faoziaziz/pa_ui/docs/LNA_recv_GW.odt

LNA Notes

Aziz Faozi 19/10/2026

# Desain Drawing

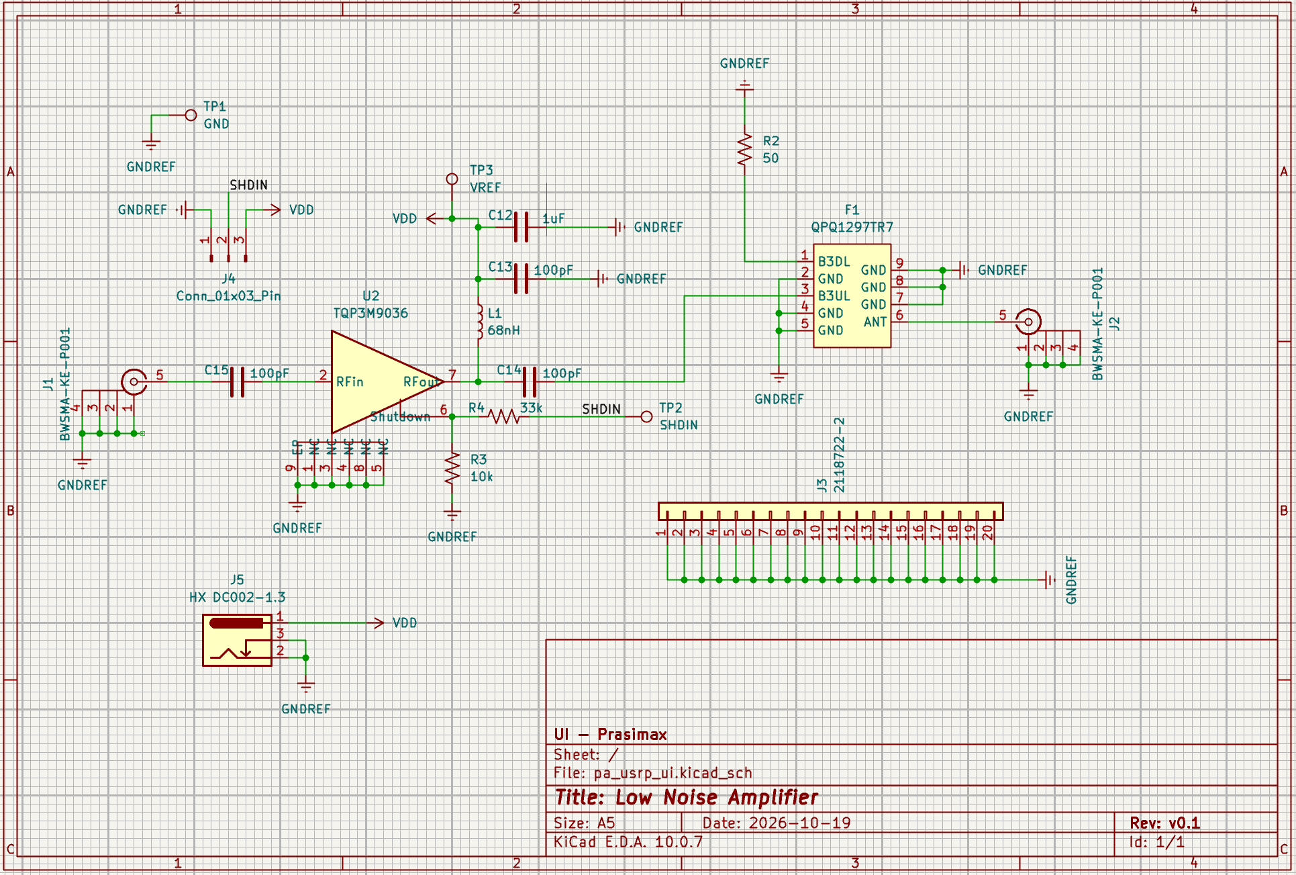
[picture p1: figure]

Figure 1: Rangkaian LNA

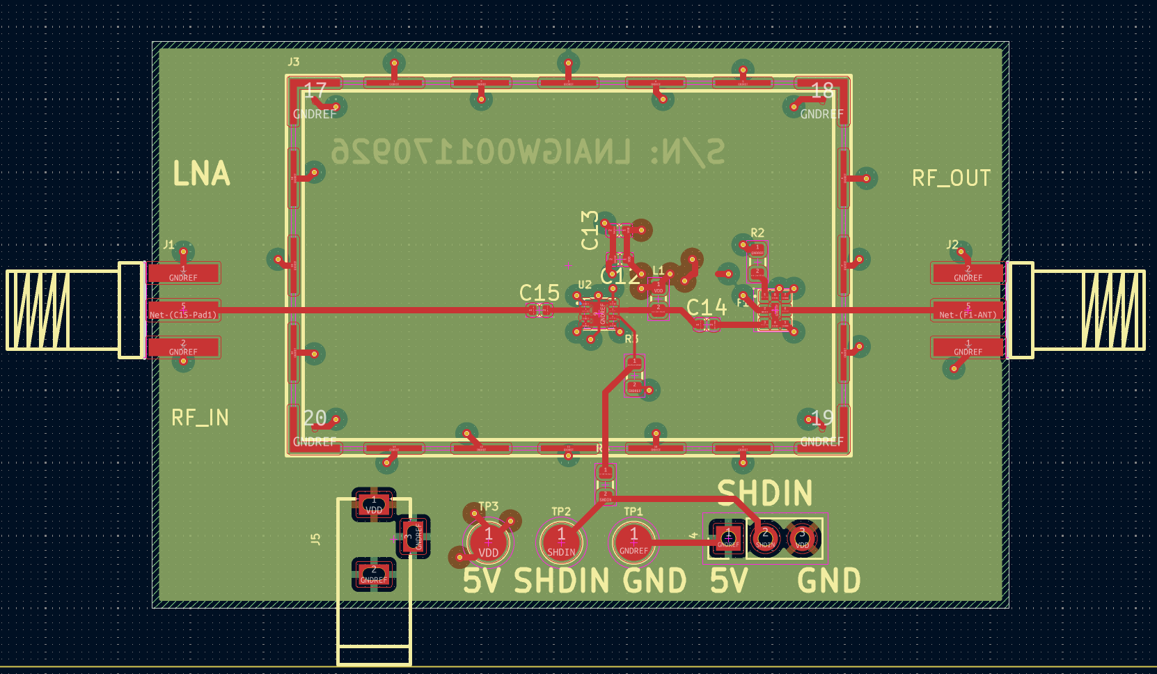
[picture p2: figure]

Figure 2: Rangkaian PCB.

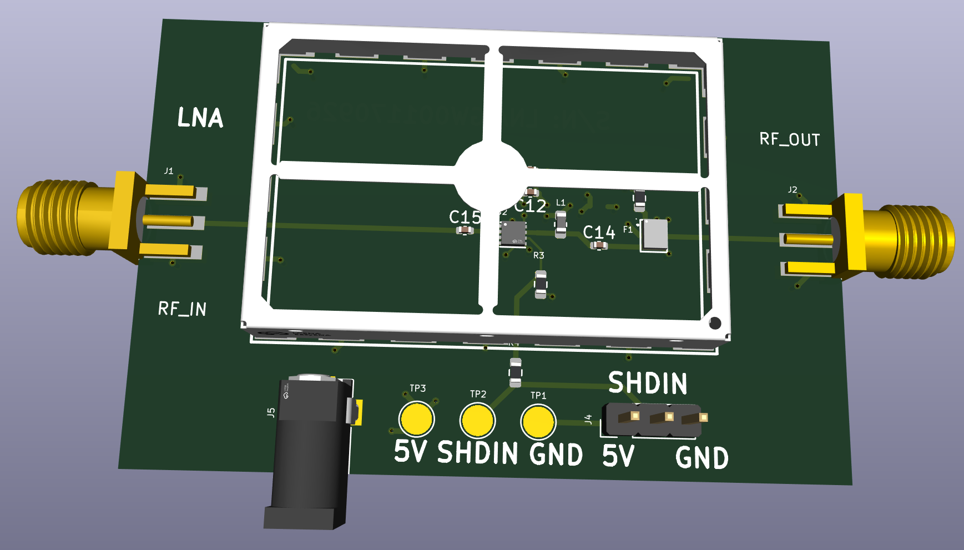
[picture p3: figure]

Figure 3: Gambar 3D dari LNA

Figure 1 adalah rangkaian Low Noise Amplifier, Figure 2 adalah bentuk PCB untuk Low Noise Amplifier. Perhatikan bahwa cara untuk mencatu amplifier tersbuet terbuka 3 pilihan yaitu dengan barrel jack seperti J5, pad untuk solder seperti test point dan pin header tulang ikan seperti pada konektor j4.

Reference | Qty | Value | price | lcsc_id | Total
C12 | 1 | 1uF | 0.01 | C52923 | 0.01
C13,C14,C15 | 3 | 100pF | 0 | C1546 | 0.01
F1 | 1 | QPQ1297TR7 | 8.01 | C471170 | 8.01
J1,J2 | 2 | BWSMA-KE-P001 | 0.41 | C496550 | 0.82
J3 | 1 | 2118722-2 | 2.01 | C5371638 | 2.01
J4 | 1 | Conn_01x03_Pin | | | 0
J5 | 1 | HX DC002-1.3 | 0.08 | C5184827 | 0.08
L1 | 1 | 68nH | 0.04 | C6364697 | 0.04
R2 | 1 | 50 | 0.03 | C849792 | 0.03
R3 | 1 | 10k | 0.01 | C25804 | 0.01
R4 | 1 | 33k | 0 | C4216 | 0
TP1 | 1 | GND | | | 0
TP2 | 1 | SHDIN | | | 0
TP3 | 1 | VREF | | | 0
U2 | 1 | TQP3M9036 | 3.13 | C920261 | 3.13
| | | | total | 14.14

# Performa Claim

Dari Figure satu kita melihat bahwa rangkaian input_rf akan melalui komponent berupa SMA connektor J1 → c15 → U2 → c13 → f1 → j2. Dengan mengetahui karakteristik dari jalur rf yang digunakan kita bisa menentukan perkiraan seperti gain maupun insertion loss dari rangkaian tersebut.

### J1,J2 : BWSMA-KE-P001

5.2mm 50Ω Board Side Inner hole Offset Pin SMA SMD Coaxial Connectors (RF) ROHS.

## F1 : QPQ1297

The QPQ1297 is a high-performance Bulk Acoustic Wave (BAW) Duplexer designed for Band 3 uplink / downlink applications.

The QPQ1297 provides low insertion loss and high rejection making it an ideal choice for Small Cells. This duplexer is housed in a compact, RoHs compliant 2.00 mm x 2.50 mm x 0.93 mm surface mount pacakge (SMP).

The QPQ1297 is part of Qorvo’s extensive portfolio of RF BAW and SAW filters.

Detail bisa dicheck https://www.qorvo.com/products/r/ra005518

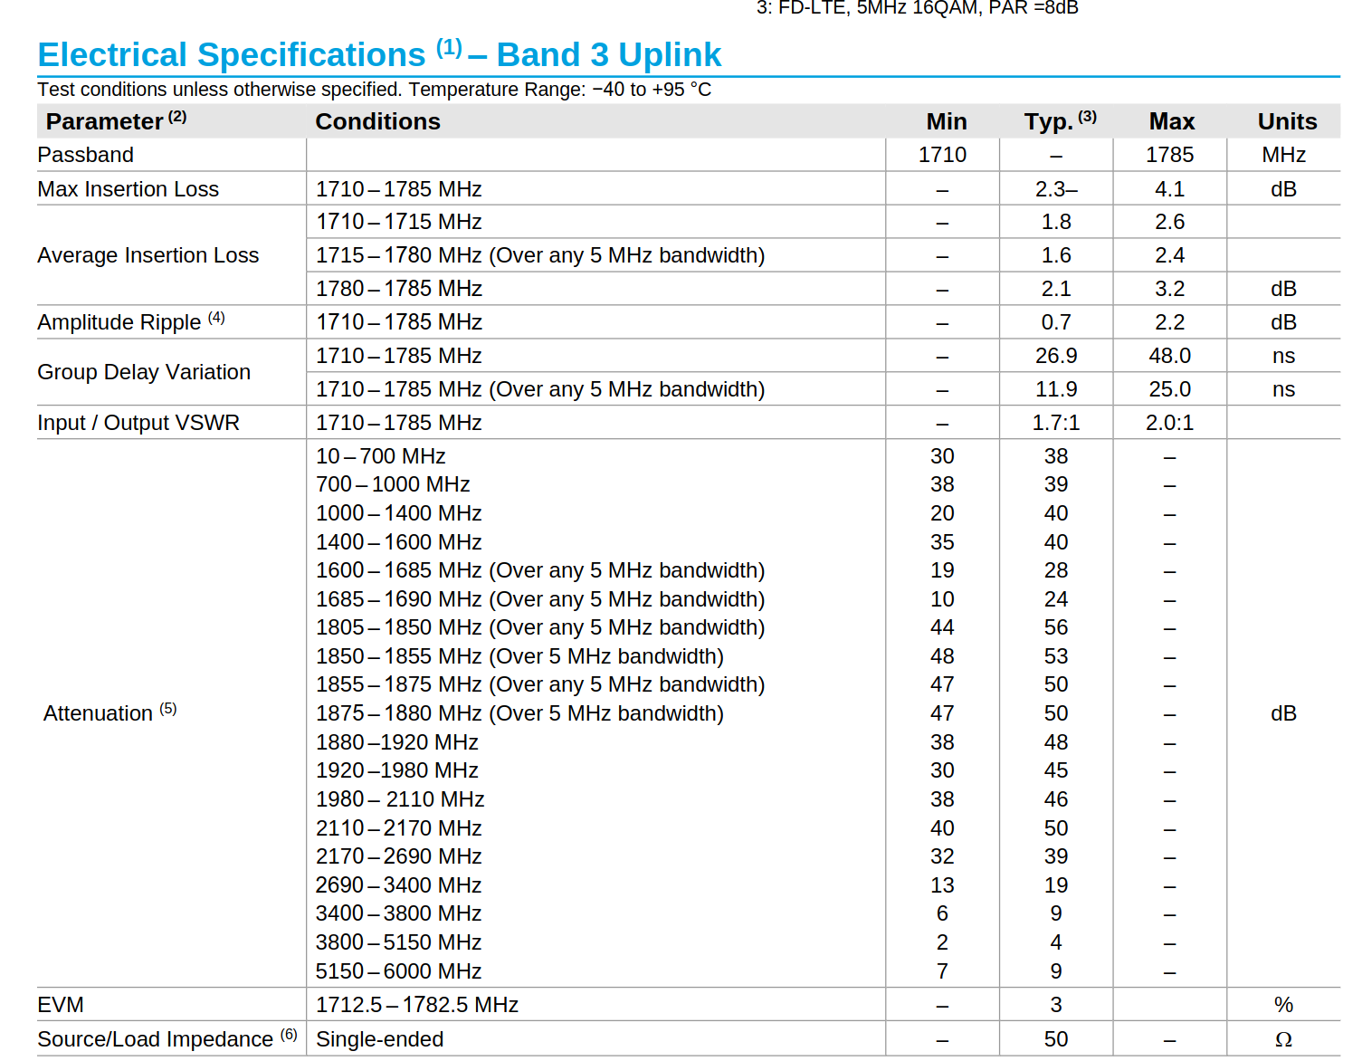
[picture p4: figure]

Figure 4: tabel untuk suhu -40 hingga +95 Celcius

## LNA IC

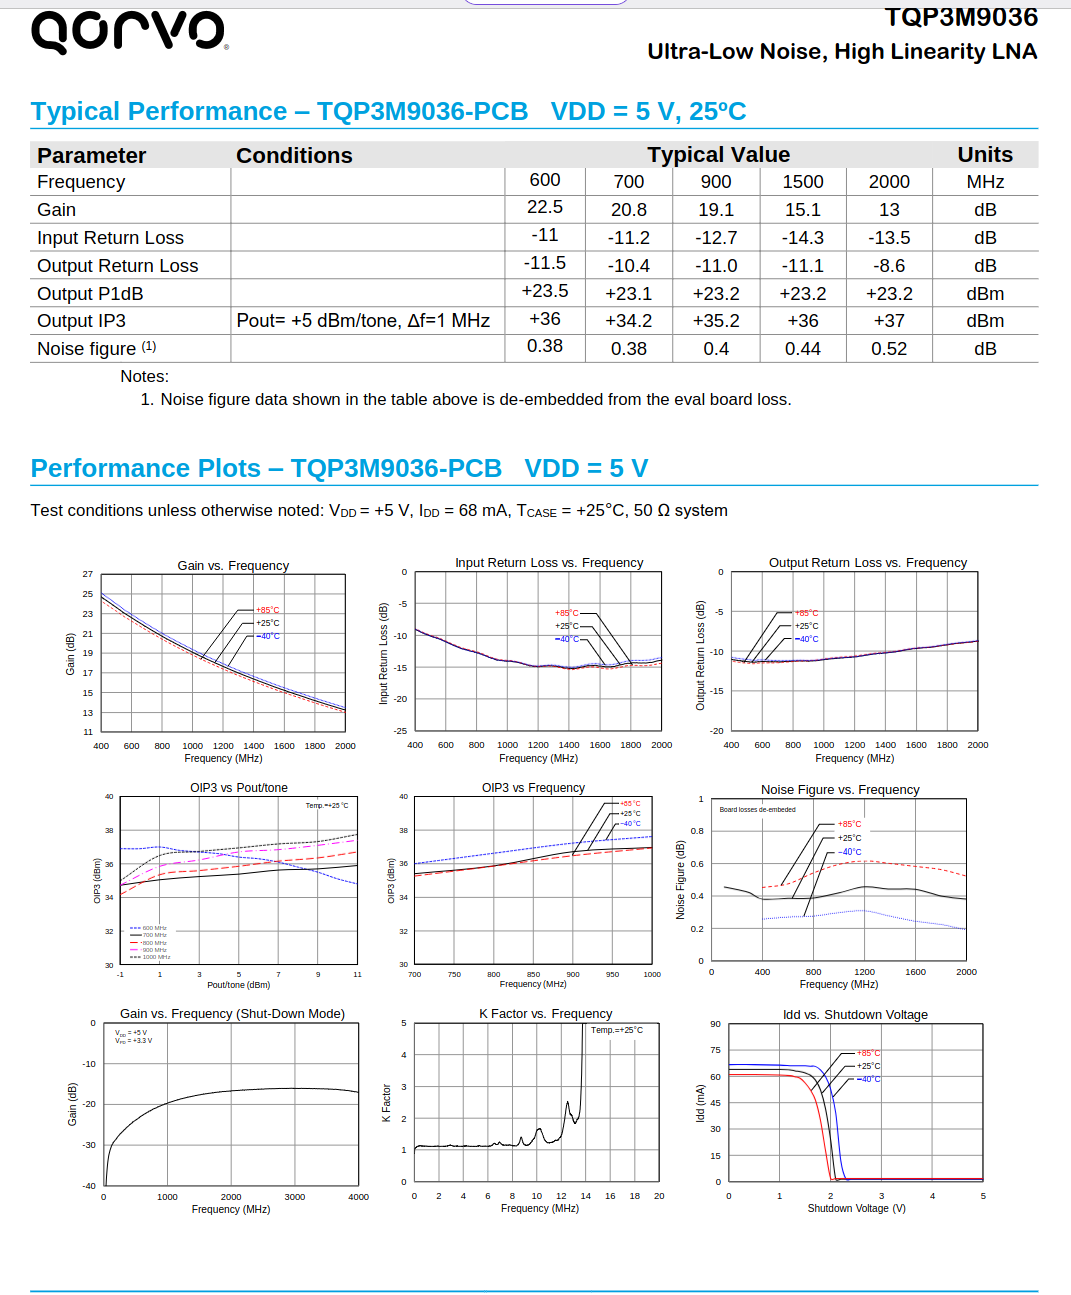
[picture p5: figure]

Detail bisa check di https://www.qorvo.com/products/r/ra004882

## PCB LNA

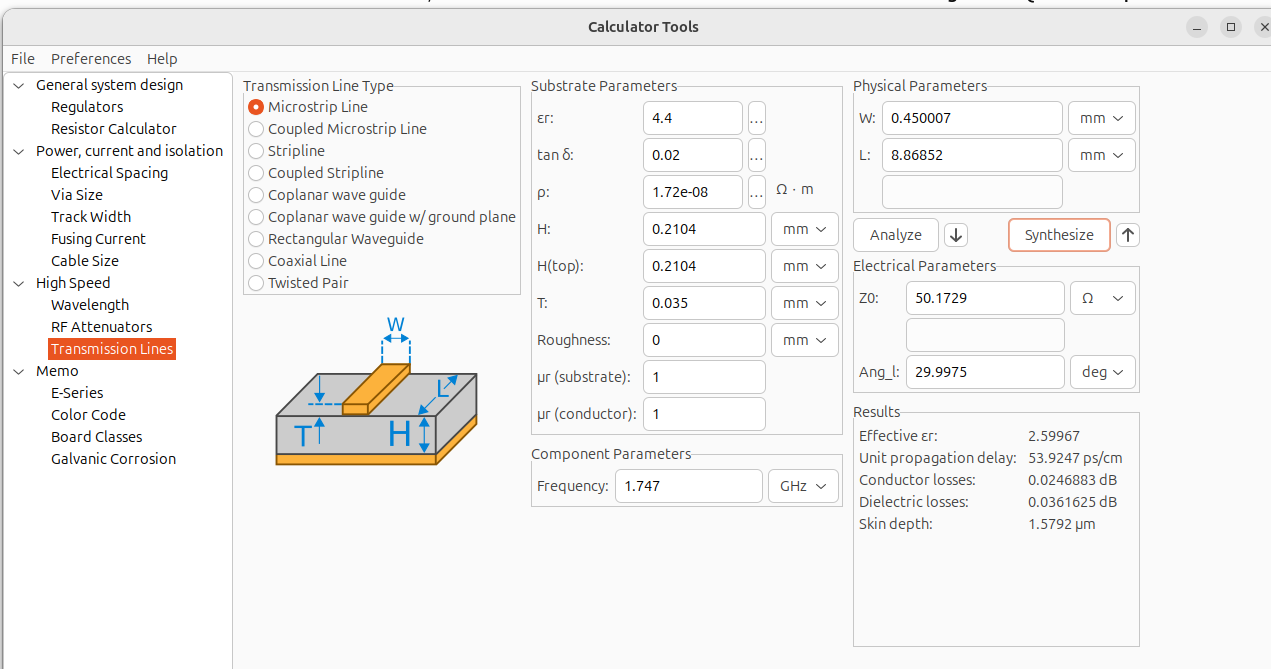
[picture p6: figure]

Z0 pada frequensi 1.747 GHz adalah 50.1729 Ohm

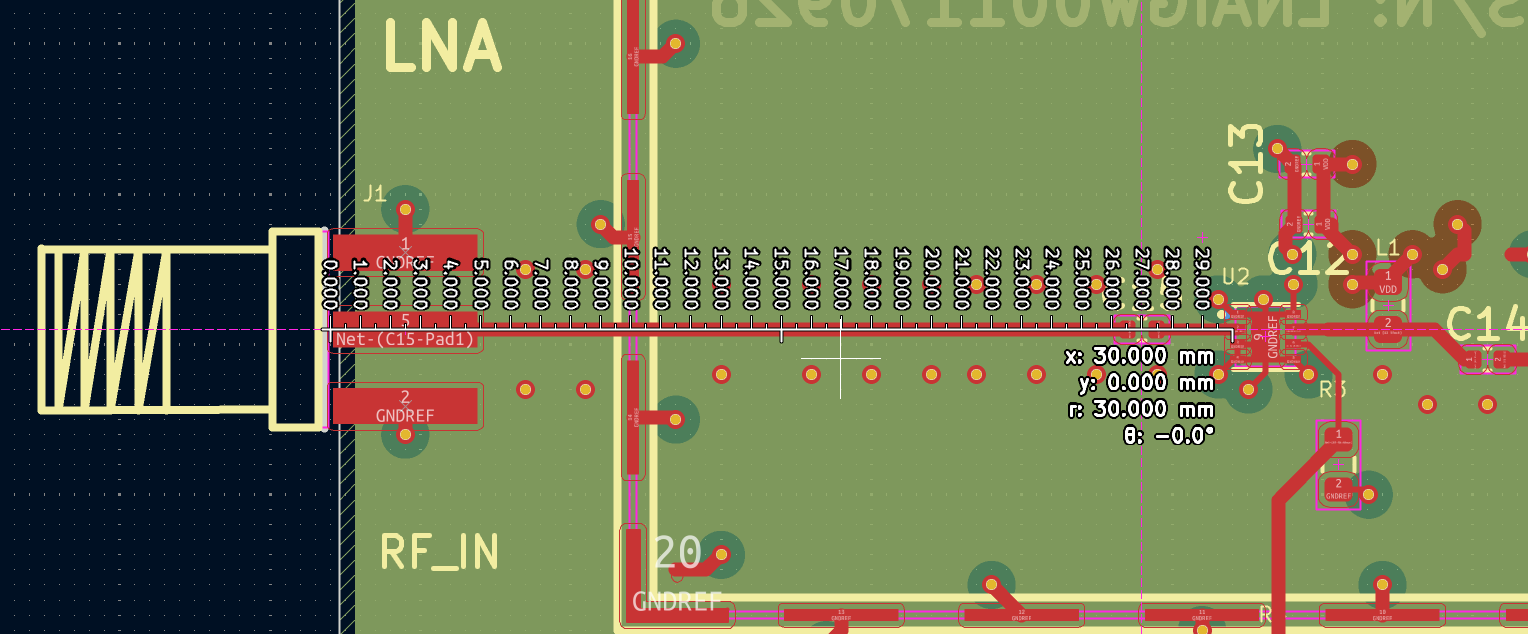
[picture p7: figure]

30 mm

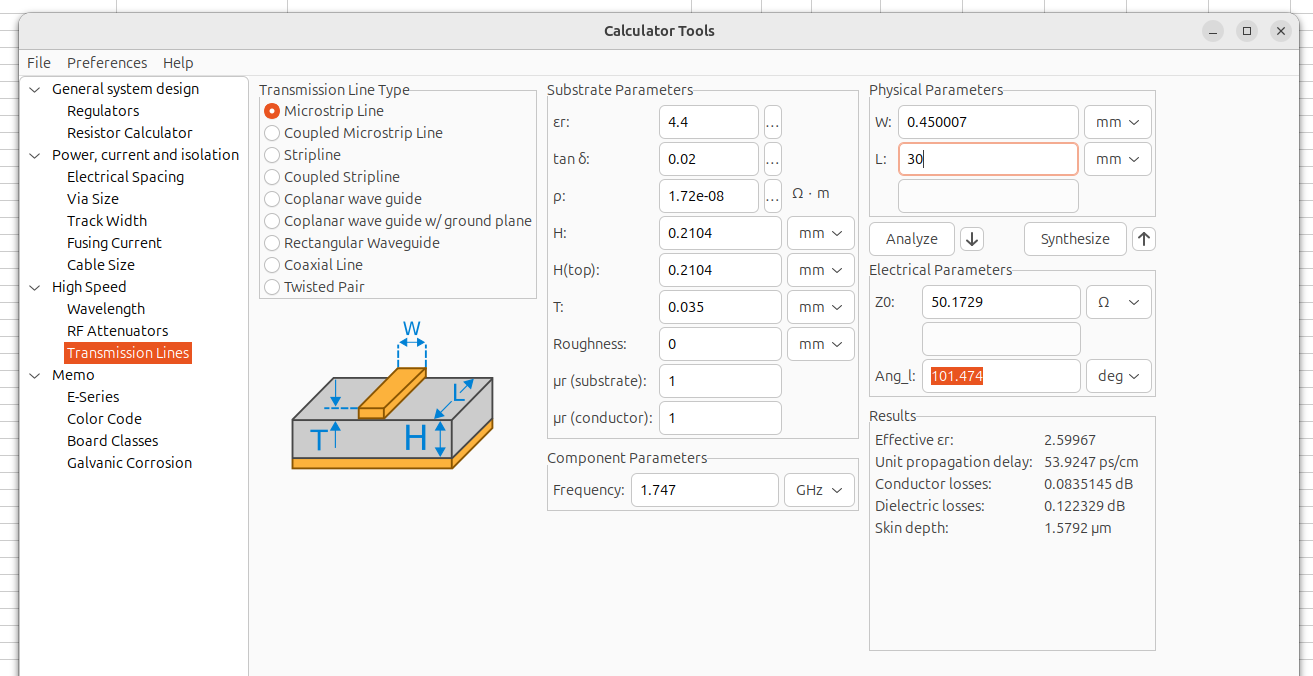
[picture p8: figure]

phase delay antara rf input dan input LNA 101.47 degree

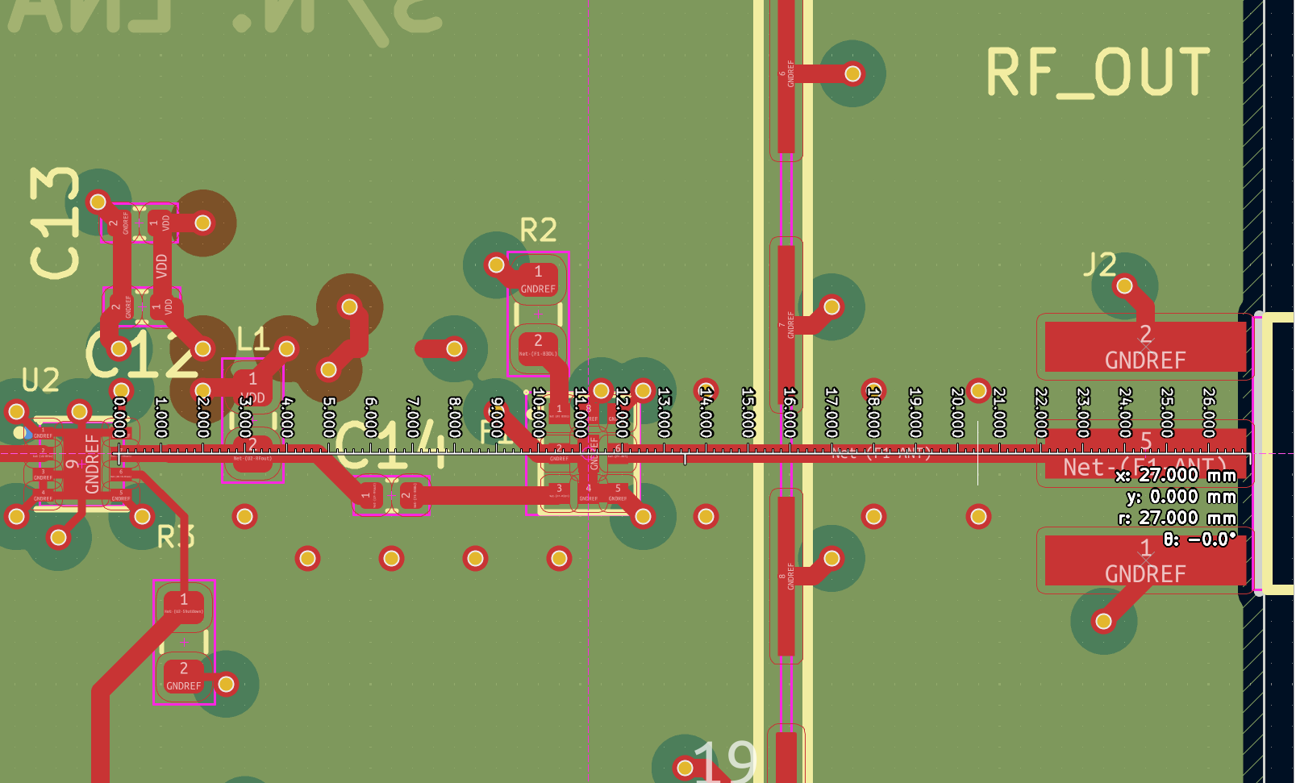
[picture p9: figure]

27 mm antara pa dan rf out.

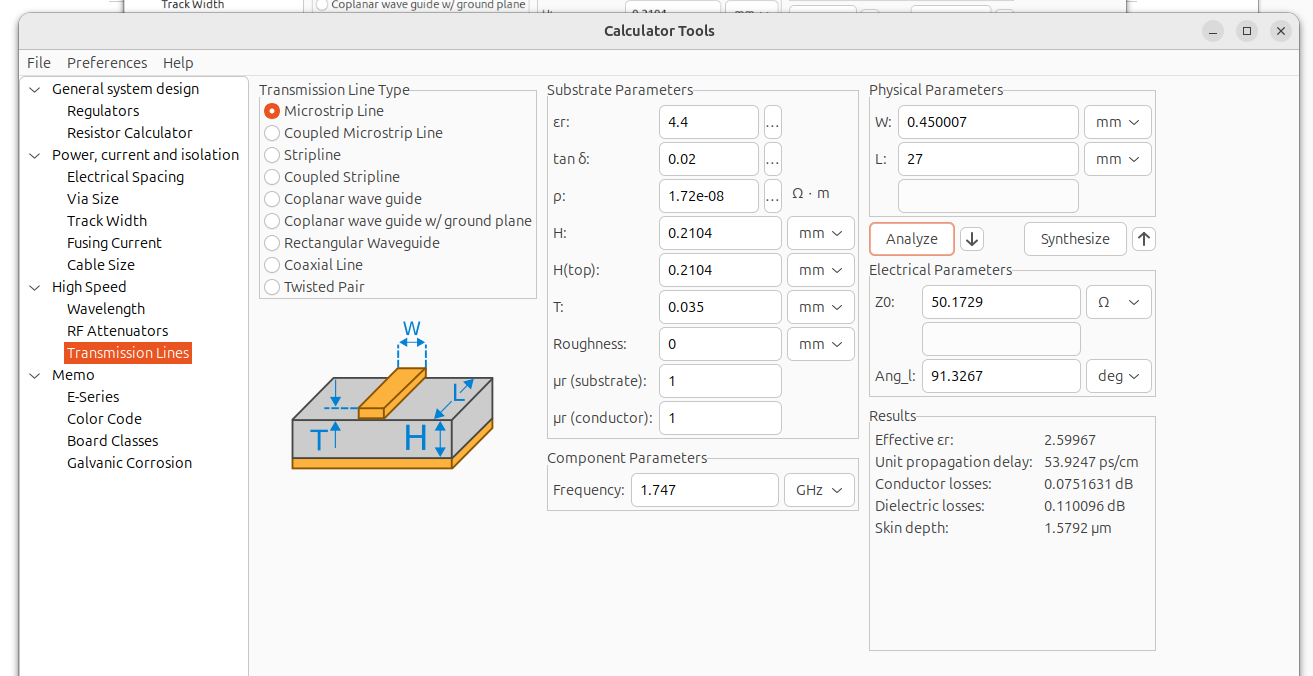
[picture p10: figure]

Phase delay antara lna dan rf output 91.3267 degree

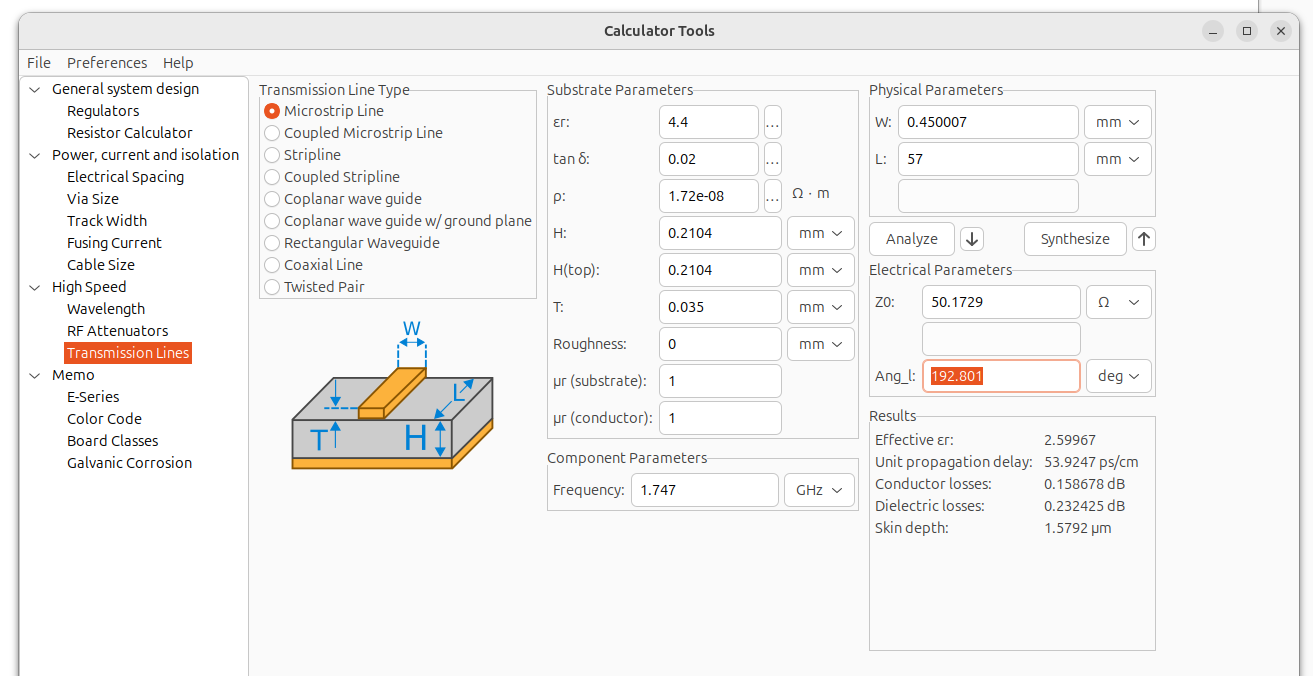
[picture p11: figure]

total delay phasa tanpa memperhitungan delay LNA dan delay filter dalah 192 degree

Z_0 = 50.1729 "ohm" newline
Z_L = 50 "ohm" newline
Gamma = {Z_L - Z_0} over {Z_L + Z_0} newline
Gamma = {50 - 50.1729} over {50 + 50.1729} newline
Gamma = {-0.1729} over {100.1729} newline
abs(Gamma) approx 0.0017257 newline
VSWR = {1 + abs(Gamma)} over {1 - abs(Gamma)} newline
VSWR = {1 + 0.0017257} over {1 - 0.0017257} newline
VSWR approx 1.00346 newline
RL = -20 log left (abs(Gamma) right ) newline
RL = -20 log left (0.0017257 right ) newline
RL approx 55.26 "dB"
