faoziaziz/pa_ui/docs/PA_GW_notes.odt

Power Amplifier UI Prof Gunawan Wibisono Notes

Date : Oct 13, 2026

Reported by : Aziz Amerul Faozi

# PCB stackup JLCPCB

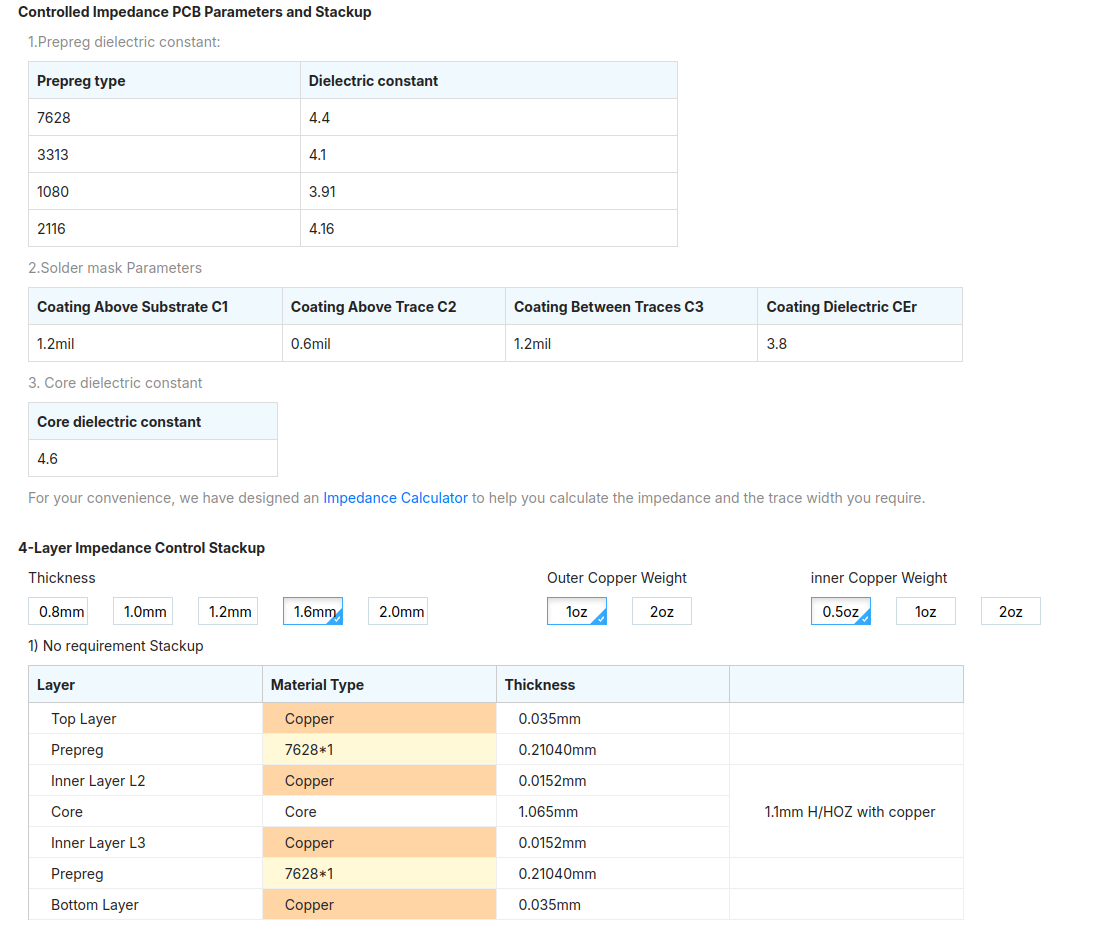
[picture p12: figure]

Figure 1: PCB Stackup

Ketemu lebar jalurnya 4.52882 dengan pcb stackup dari jlcpcb supaya z0 50 ohm

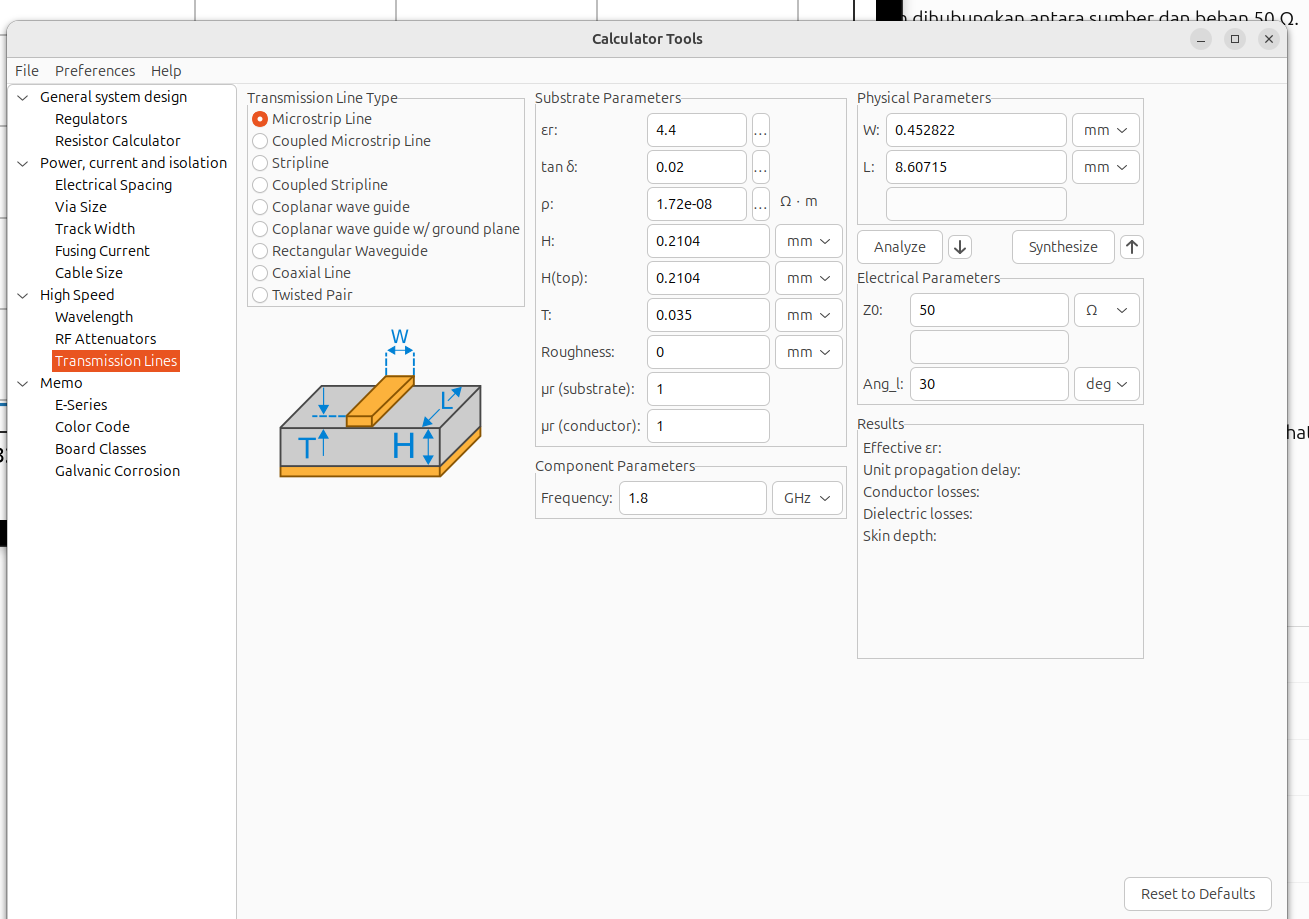
[picture p13: figure]

Figure 2: Kalkulator Ideal untuk 50 Ohm

Pcb stackup optimized Z0 nya 50.1729 itung itungan vswr : 1.0036

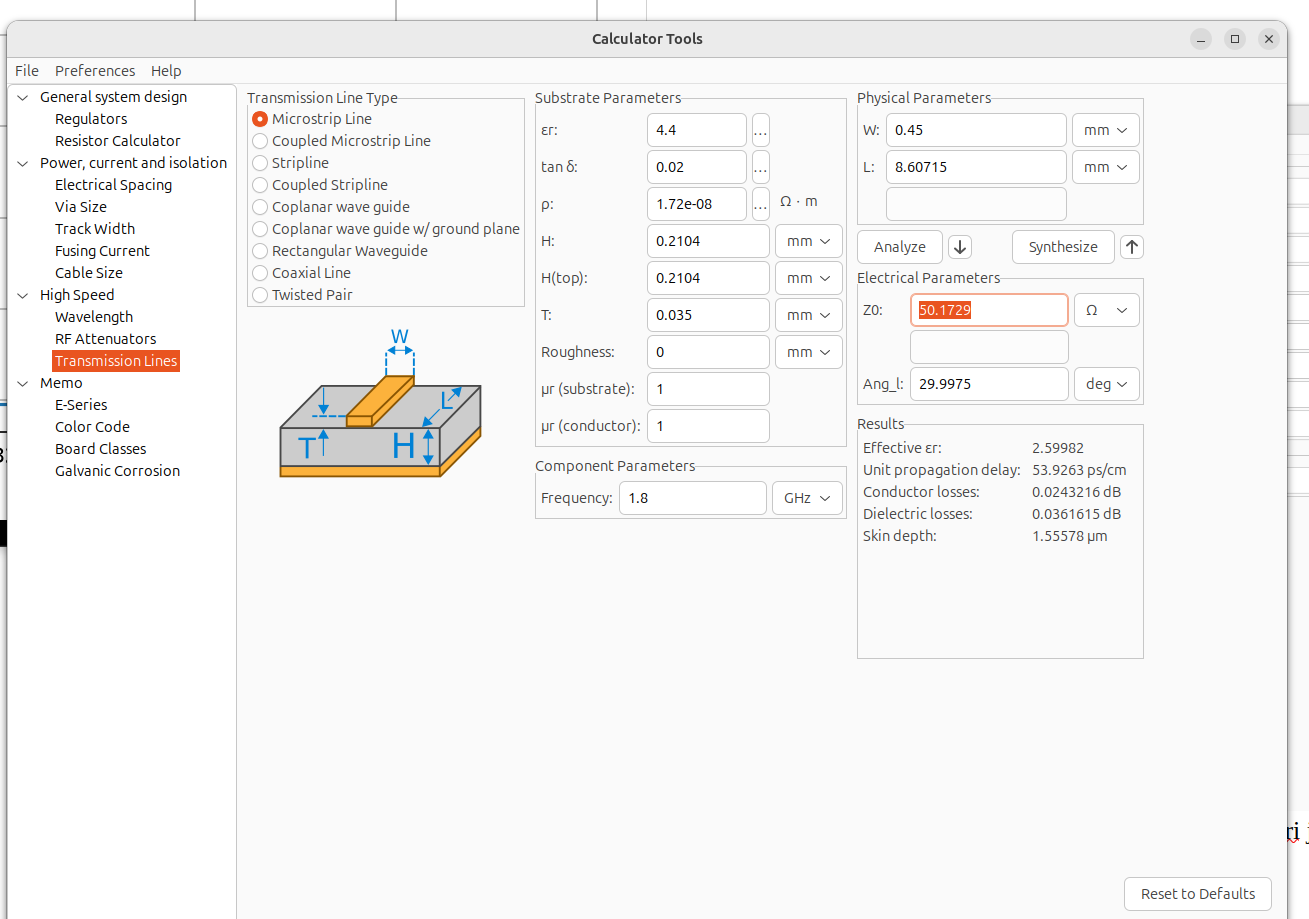
[picture p14: figure]

Figure 3: Calculator untuk feasible development

23 mm antara feed dan PA

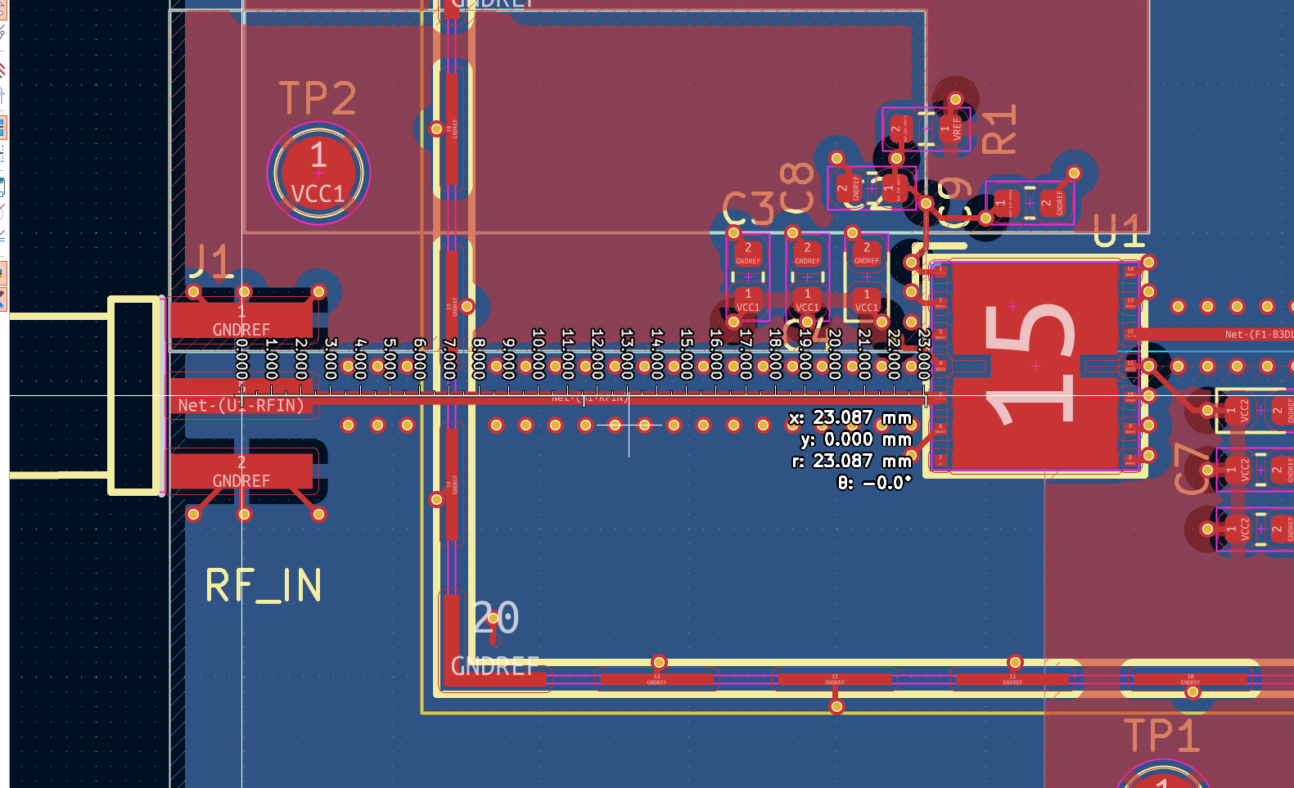
[picture p15: figure]

Figure 4: Jalur Feed ke PA

9 mm antara output pa dan tikungan

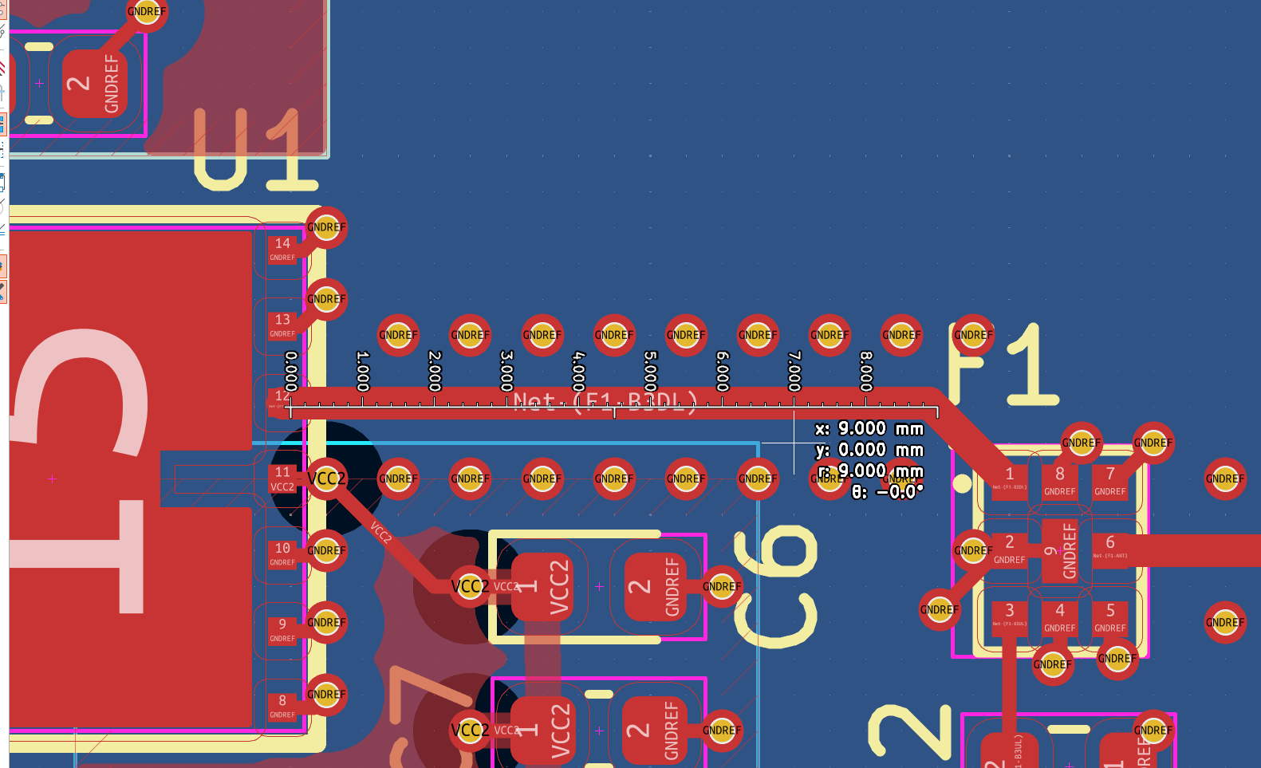
[picture p16: figure]

Figure 5: Jalur PA ke tikungan filter

tikungan dan filter 1 mm

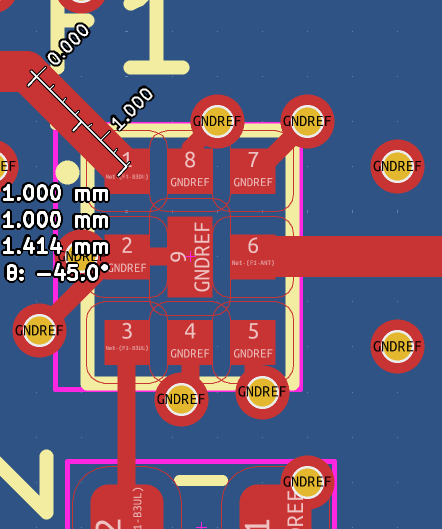
[picture p17: figure]

Figure 6: Jalur tikungan ke filter

14 mm filter ke feed

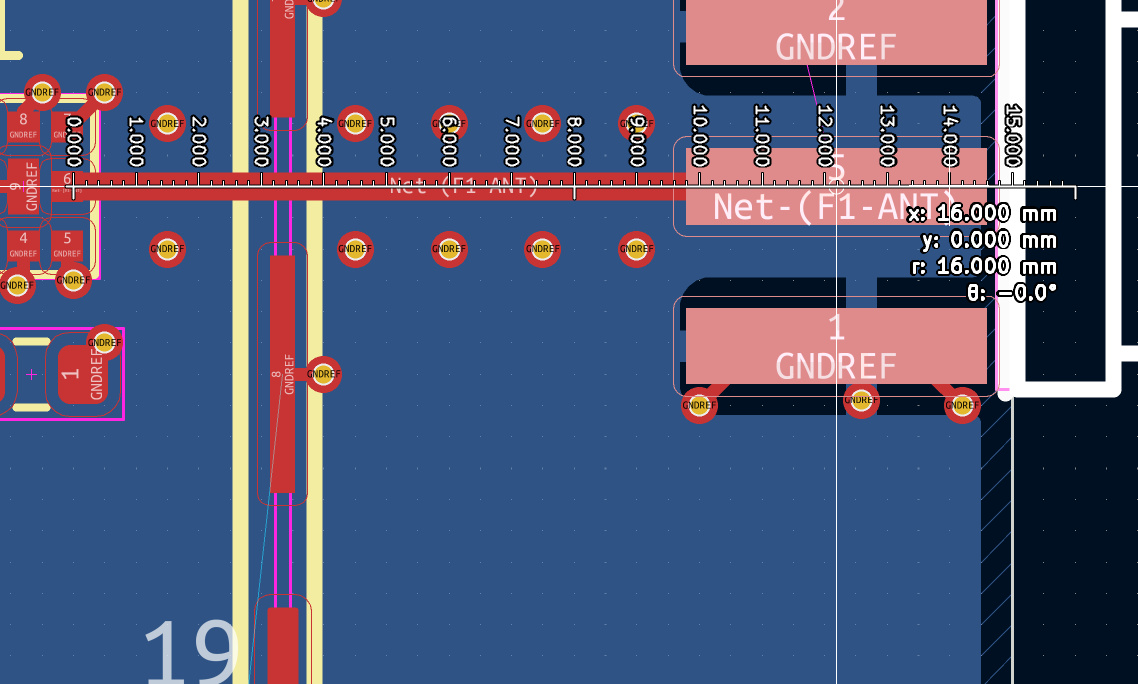
[picture p18: figure]

Figure 7: Jalur Filter ke Feed

total jalur ditempuh 22+10+14 = 46 mm

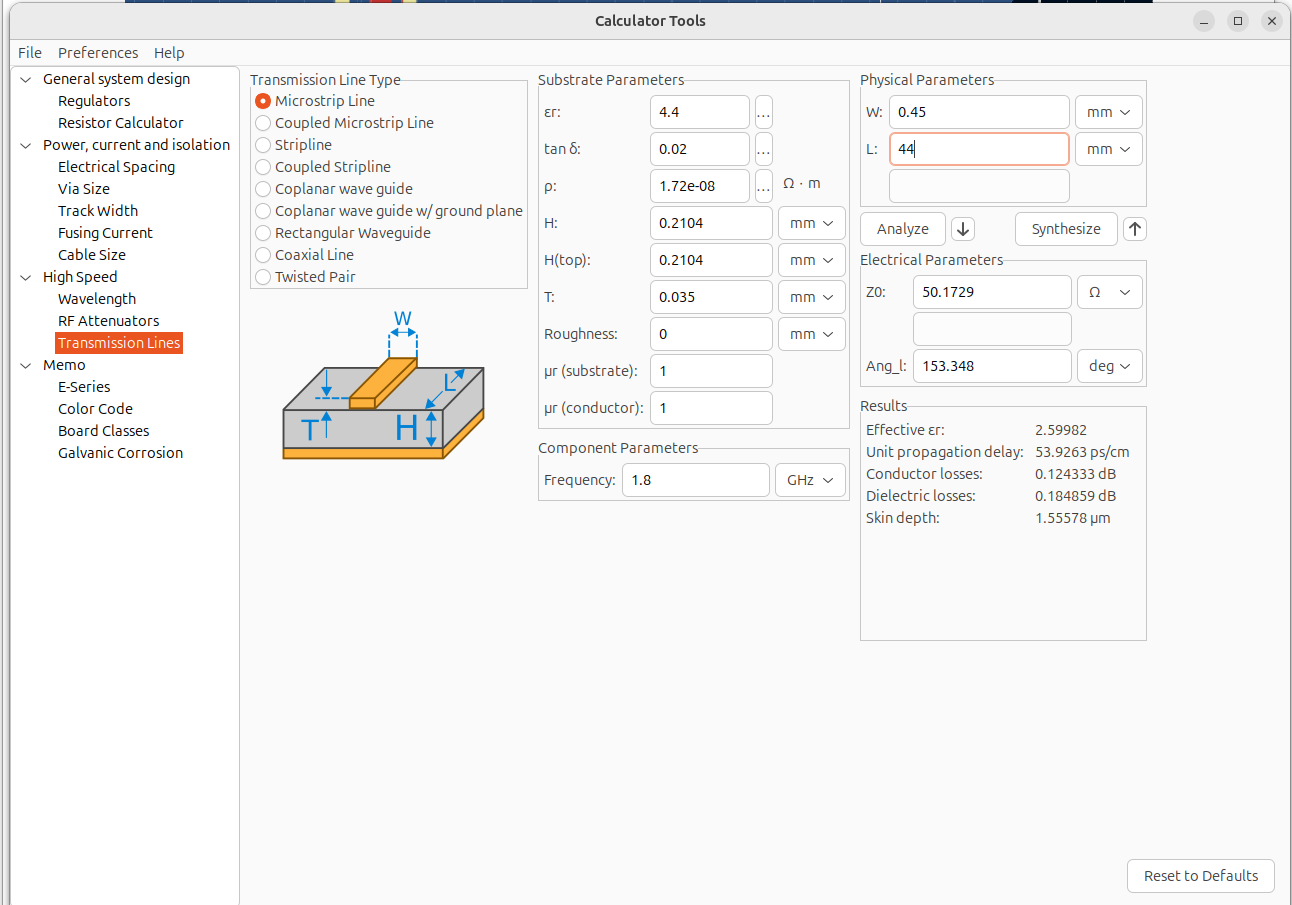
[picture p19: figure]

total conduction loss

unit propagation delay : 53.92,63 ps/cm

conductor loses : 0.12433 dB

dielektrik lose : 0.184859 dB

perubahan fasa : 153.348

vswr PCB = (1+|(50.1729 - 50)/(50.1729 - 50)|)/(1-|(50.1729 - 50)/(50.1729 – 50)|)=1.0036

notes : untuk supply DC ataupun penyelelaras gelombang (siapa tahu ingin 0 degree) perlu requirement.
