faoziaziz/pa_ui/docs/LNA_report.odt

# Low Noise Amplifier Projects Notes

by Aziz Faozi

18 Oct 2026

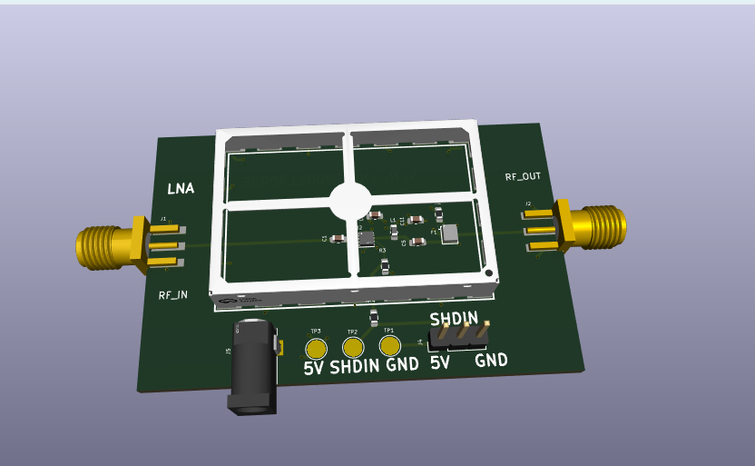
[picture p20: figure]
