faoziaziz/pa_ui/simulasi/sim_J1_RFIN/S11_J1_RFIN.png

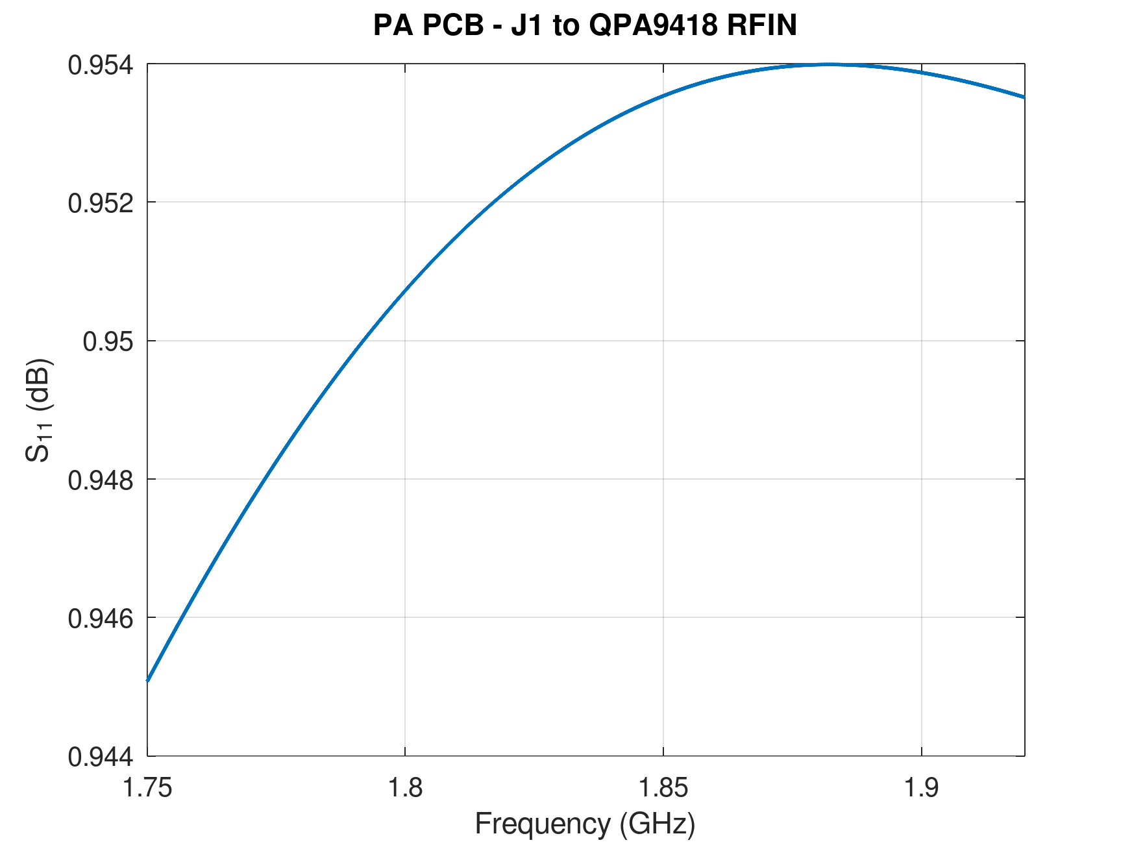
simulasi/sim_J1_RFIN/S11_J1_RFIN.png
