faoziaziz/pa_ui/pa_usrp_ui_lna.csv

Reference | Qty | Value | DNP | Exclude from BOM | Exclude from Board | Exclude from Simulation | Exclude from Position Files | Footprint | Datasheet | price | lcsc_id
C12 | 1 | 1uF |  |  |  |  | ${EXCLUDE_FROM_POS_FILES} | Capacitor_SMD:C_0402_1005Metric |  | 0.0068 | C52923
C13,C14,C15 | 3 | 100pF |  |  |  |  | ${EXCLUDE_FROM_POS_FILES} | Capacitor_SMD:C_0402_1005Metric |  | 0.0033 | C1546
F1 | 1 | QPQ1297TR7 |  |  |  |  | ${EXCLUDE_FROM_POS_FILES} | fooptrints:FILTER-SMD_9P-L2.5-W2.0-BL_QPQ1297TR7 |  | 8.0068 | C471170
J1,J2 | 2 | BWSMA-KE-P001 |  |  |  |  | ${EXCLUDE_FROM_POS_FILES} | fooptrints:SMA-SMD_BWSMA-KE-P001 |  | 0.41 | C496550
J3 | 1 | 2118722-2 |  |  |  |  | ${EXCLUDE_FROM_POS_FILES} | fooptrints:CONN-SMD_2118722-2 |  | 2.01 | C5371638
J4 | 1 | Conn_01x03_Pin |  |  |  |  | ${EXCLUDE_FROM_POS_FILES} | Connector_PinHeader_2.54mm:PinHeader_1x03_P2.54mm_Vertical
J5 | 1 | HX DC002-1.3 |  |  |  |  | ${EXCLUDE_FROM_POS_FILES} | fooptrints:DC-IN-TH_HANXIA_HX-DC002-1.3 |  | 0.0804 | C5184827
L1 | 1 | 68nH |  |  |  |  | ${EXCLUDE_FROM_POS_FILES} | Inductor_SMD:L_0603_1608Metric |  | 0.0414 | C6364697
R2 | 1 | 50 |  |  |  |  | ${EXCLUDE_FROM_POS_FILES} | Resistor_SMD:R_0603_1608Metric |  | 0.0263 | C849792
R3 | 1 | 10k |  |  |  |  | ${EXCLUDE_FROM_POS_FILES} | Resistor_SMD:R_0603_1608Metric |  | 0.0054 | C25804
R4 | 1 | 33k |  |  |  |  | ${EXCLUDE_FROM_POS_FILES} | Resistor_SMD:R_0603_1608Metric |  | 0.0021 | C4216
TP1 | 1 | GND |  |  |  |  | ${EXCLUDE_FROM_POS_FILES} | TestPoint:TestPoint_Pad_D2.5mm
TP2 | 1 | SHDIN |  |  |  |  | ${EXCLUDE_FROM_POS_FILES} | TestPoint:TestPoint_Pad_D2.5mm
TP3 | 1 | VREF |  |  |  |  | ${EXCLUDE_FROM_POS_FILES} | TestPoint:TestPoint_Pad_D2.5mm
U2 | 1 | TQP3M9036 |  |  |  |  | ${EXCLUDE_FROM_POS_FILES} | fooptrints:DFN-8_L2.0-W2.0-P0.50-BL-EP |  | 3.1317 | C920261
