faoziaziz/pa_ui/pa_usrp_ui.ods

Reference | Qty | Value | DNP | Exclude from BOM | Exclude from Board | Exclude from Simulation | Exclude from Position Files | Footprint | Datasheet | price | lcsc_id | total
C2,C6 | 2 | 10.0uF |  |  |  |  | ${EXCLUDE_FROM_POS_FILES} | Diode_SMD:D_0603_1608Metric |  | 0.0542 | C96446 | 0.1084
C3,C9,C10 | 3 | 0.1uF |  |  |  |  | ${EXCLUDE_FROM_POS_FILES} | Capacitor_SMD:C_0603_1608Metric |  | 0.0124 | C14663 | 0.0372
C4,C7 | 2 | 1000pF |  |  |  |  | ${EXCLUDE_FROM_POS_FILES} | Capacitor_SMD:C_0603_1608Metric |  | 0.0089 | C1588 | 0.0178
C8 | 1 | 100pF |  |  |  |  | ${EXCLUDE_FROM_POS_FILES} | Capacitor_SMD:C_0603_1608Metric |  | 0.0085 | C14858 | 0.0085
F1 | 1 | QPQ1297TR7 |  |  |  |  | ${EXCLUDE_FROM_POS_FILES} | fooptrints:FILTER-SMD_9P-L2.5-W2.0-BL_QPQ1297TR7 |  | 8.0068 | C471170 | 8.0068
J1,J2 | 2 | BWSMA-KE-P001 |  |  |  |  | ${EXCLUDE_FROM_POS_FILES} | fooptrints:SMA-SMD_BWSMA-KE-P001 |  | 0.41 | C496550 | 0.82
J3 | 1 | 2118722-2 |  |  |  |  | ${EXCLUDE_FROM_POS_FILES} | fooptrints:CONN-SMD_2118722-2 |  | 2.01 | C5371638 | 2.01
R1 | 1 | 0 |  |  |  |  | ${EXCLUDE_FROM_POS_FILES} | Resistor_SMD:R_0603_1608Metric |  | 0.0026 | C21189 | 0.0026
R2 | 1 | 50 |  |  |  |  | ${EXCLUDE_FROM_POS_FILES} | Resistor_SMD:R_0603_1608Metric |  | 0.0285 | C849792 | 0.0285
TP1 | 1 | VCC1 |  |  |  |  | ${EXCLUDE_FROM_POS_FILES} | TestPoint:TestPoint_Pad_D2.5mm |  |  |  | 0
TP2 | 1 | VCC2 |  |  |  |  | ${EXCLUDE_FROM_POS_FILES} | TestPoint:TestPoint_Pad_D2.5mm |  |  |  | 0
TP3 | 1 | VREF |  |  |  |  | ${EXCLUDE_FROM_POS_FILES} | TestPoint:TestPoint_Pad_D2.5mm |  |  |  | 0
U1 | 1 | QPA9418TR13 |  |  |  |  | ${EXCLUDE_FROM_POS_FILES} | fooptrints:DFN-14_L7.0-W7.0-P1.06-TL-EP_QPA9418TR13 |  | 3.67 | C18186212 | 3.67
 |  |  |  |  |  |  |  |  |  |  |  | 14.7098
