faoziaziz/pa_ui/simulasi/sim_J1_RFIN/S11_J1_RFIN.pdf

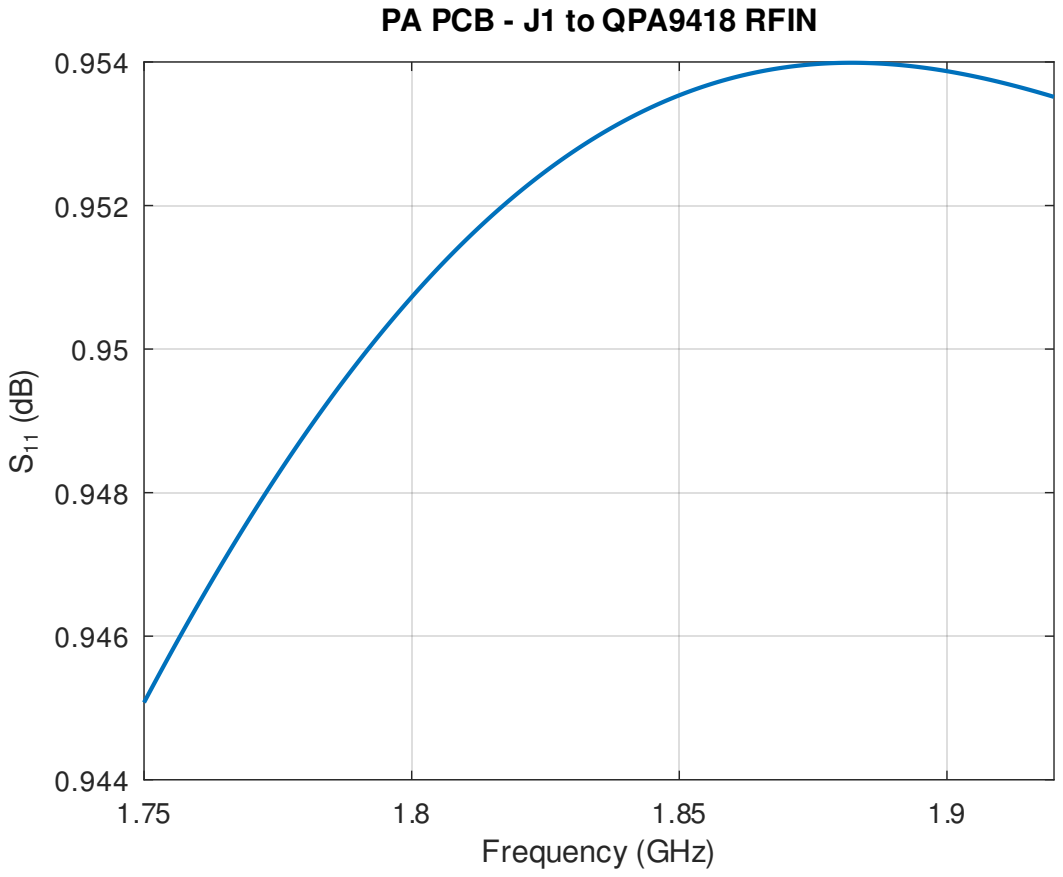
[picture p23: page 1]
Frequency (GHz)

PA PCB - J1 to QPA9418 RFIN
