faoziaziz/pa_ui/simulasi/sim_J1_RFIN/S21_J1_RFIN.pdf

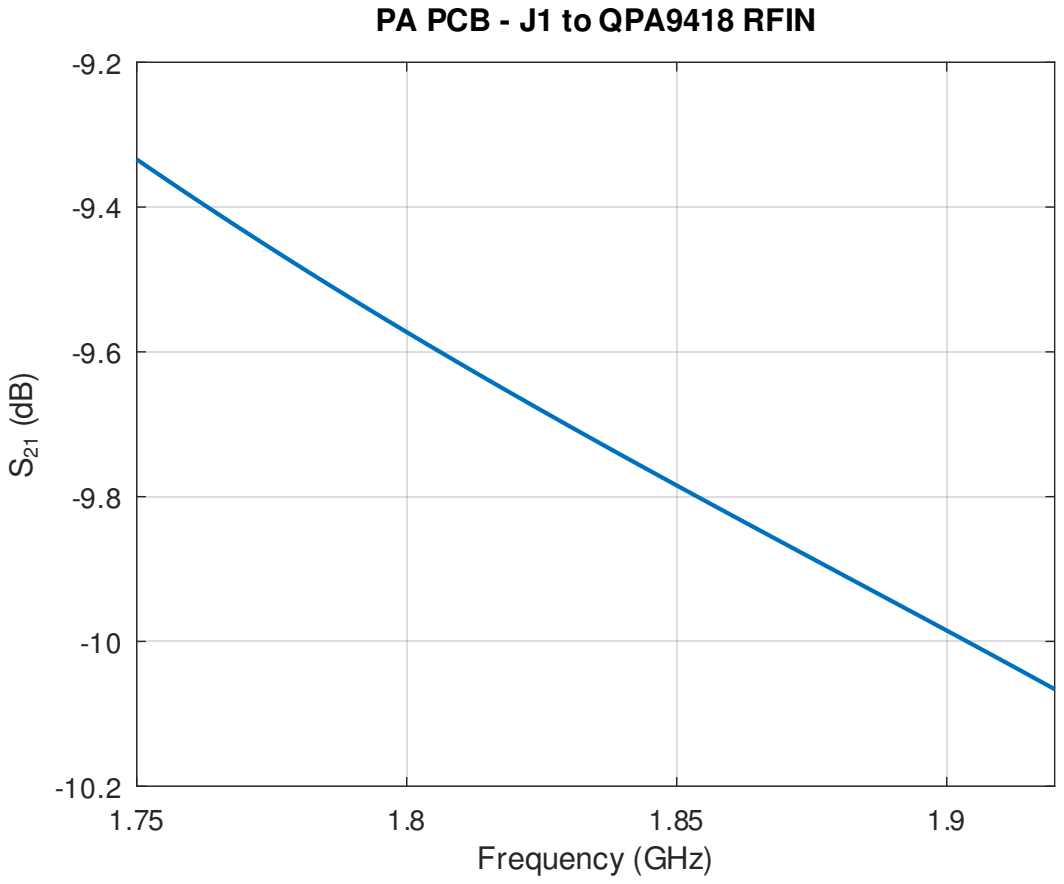
[picture p24: page 1]
Frequency (GHz)

PA PCB - J1 to QPA9418 RFIN
