faoziaziz/pa_ui/(list of files, drawings)

Other design files:
simulasi/pcb_geometry.json
