faoziaziz/pa_ui/pa_usrp_ui.kicad_pcb

## KiCad design pa_usrp_ui.kicad_pcb (2026-10-20)

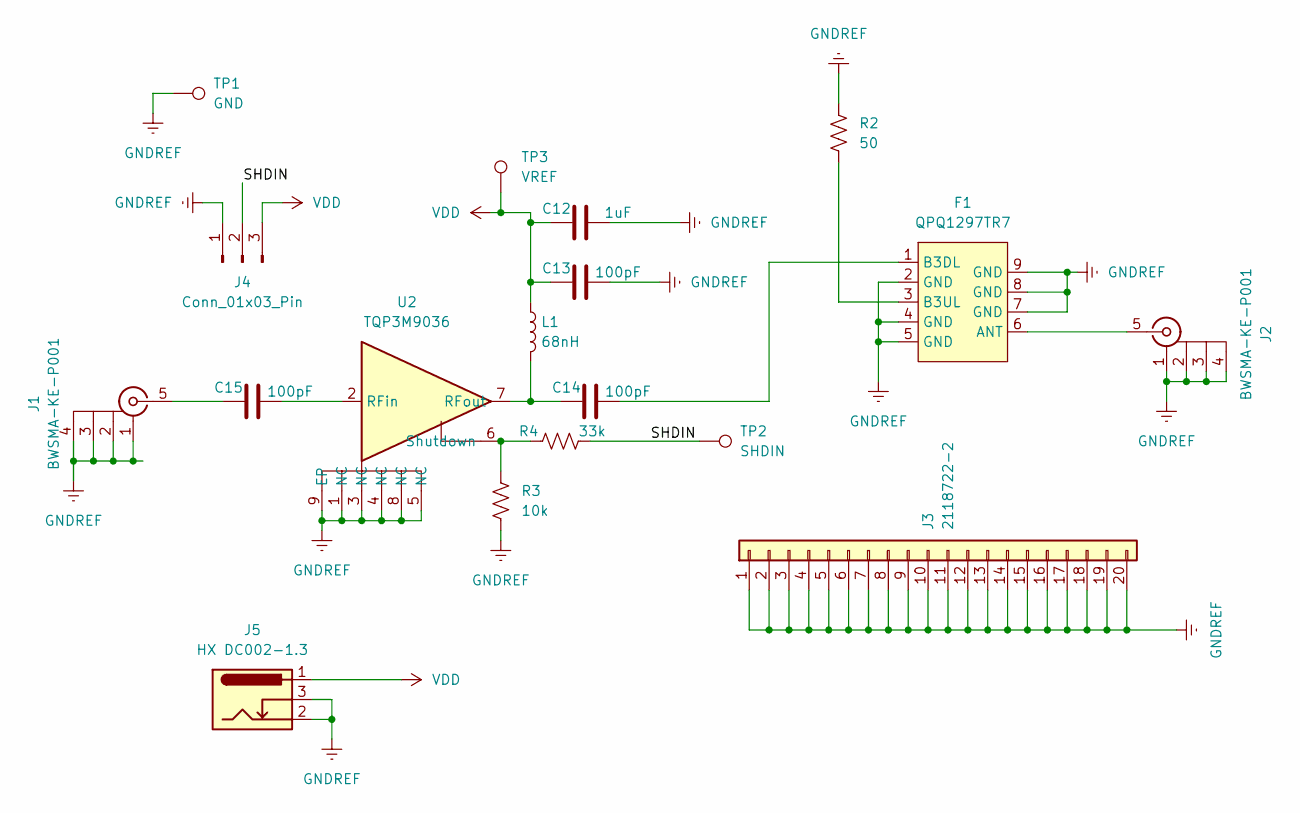
[picture p25: schematic pa_usrp_ui.kicad_sch, Low Noise Amplifier]

Parts:
C12: 1uF; C_0402_1005Metric; lcsc_id C52923
C13, C14, C15: 100pF; C_0402_1005Metric; lcsc_id C1546
F1: QPQ1297TR7; FILTER-SMD_9P-L2.5-W2.0-BL_QPQ1297TR7; lcsc_id C471170
J1, J2: BWSMA-KE-P001; SMA-SMD_BWSMA-KE-P001; lcsc_id C496550
J3: 2118722-2; CONN-SMD_2118722-2; lcsc_id C5371638
J4: Conn_01x03_Pin; PinHeader_1x03_P2.54mm_Vertical
J5: HX DC002-1.3; DC-IN-TH_HANXIA_HX-DC002-1.3; lcsc_id C5184827
L1: 68nH; L_0603_1608Metric; lcsc_id C6364697
R2: 50; R_0603_1608Metric; lcsc_id C849792
R3: 10k; R_0603_1608Metric; lcsc_id C25804
R4: 33k; R_0603_1608Metric; lcsc_id C4216
TP1: GND; TestPoint_Pad_D2.5mm
TP2: SHDIN; TestPoint_Pad_D2.5mm
TP3: VREF; TestPoint_Pad_D2.5mm
U2: TQP3M9036; DFN-8_L2.0-W2.0-P0.50-BL-EP; lcsc_id C920261

Connections:
/SHDIN: J4.2, R4.2, TP2.1 (1_1)
GNDREF: C12.2, C13.2, F1.2 (GND), F1.4 (GND), F1.5 (GND), F1.7 (GND), F1.8 (GND), F1.9 (GND), J1.1, J1.2, J1.3, J1.4, J2.1, J2.2, J2.3, J2.4, J3.1, J3.2, J3.3, J3.4, J3.5, J3.6, J3.7, J3.8, J3.9, J3.10, J3.11, J3.12, J3.13, J3.14, J3.15, J3.16, J3.17, J3.18, J3.19, J3.20, J4.1, J5.2, J5.3, R2.1, R3.2, TP1.1 (1_1), U2.1 (NC), U2.3 (NC), U2.4 (NC), U2.5 (NC), U2.8 (NC), U2.9 (EP)
unnamed: C15.1, J1.5
unnamed: F1.6 (ANT), J2.5
unnamed: C14.2, F1.1 (B3DL)
unnamed: F1.3 (B3UL), R2.2
unnamed: C15.2, U2.2 (RFin)
unnamed: C14.1, L1.2, U2.7 (RFout)
unnamed: R3.1, R4.1, U2.6 (Shutdown)
VDD: C12.1, C13.1, J4.3, J5.1, L1.1, TP3.1 (1_1)

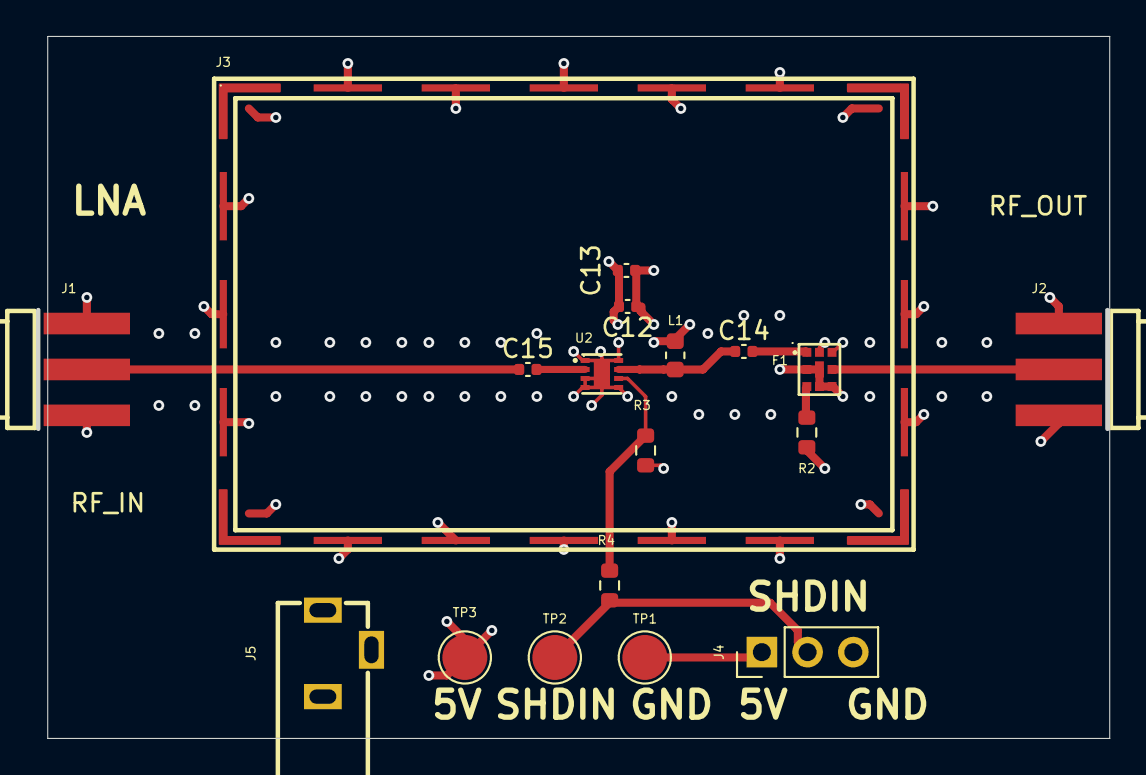
[picture p26: board pa_usrp_ui.kicad_pcb from above]

Board: 4 copper layers, 59.5 x 39.0 mm, 18 parts (0 on the bottom side), 10 nets.
