faoziaziz/pa_ui/_restore_backup_2026-10-14T10-31-09-348/pa_usrp_ui.kicad_pcb

## KiCad design _restore_backup_2026-10-14T10-31-09-348/pa_usrp_ui.kicad_pcb (2026-10-14)

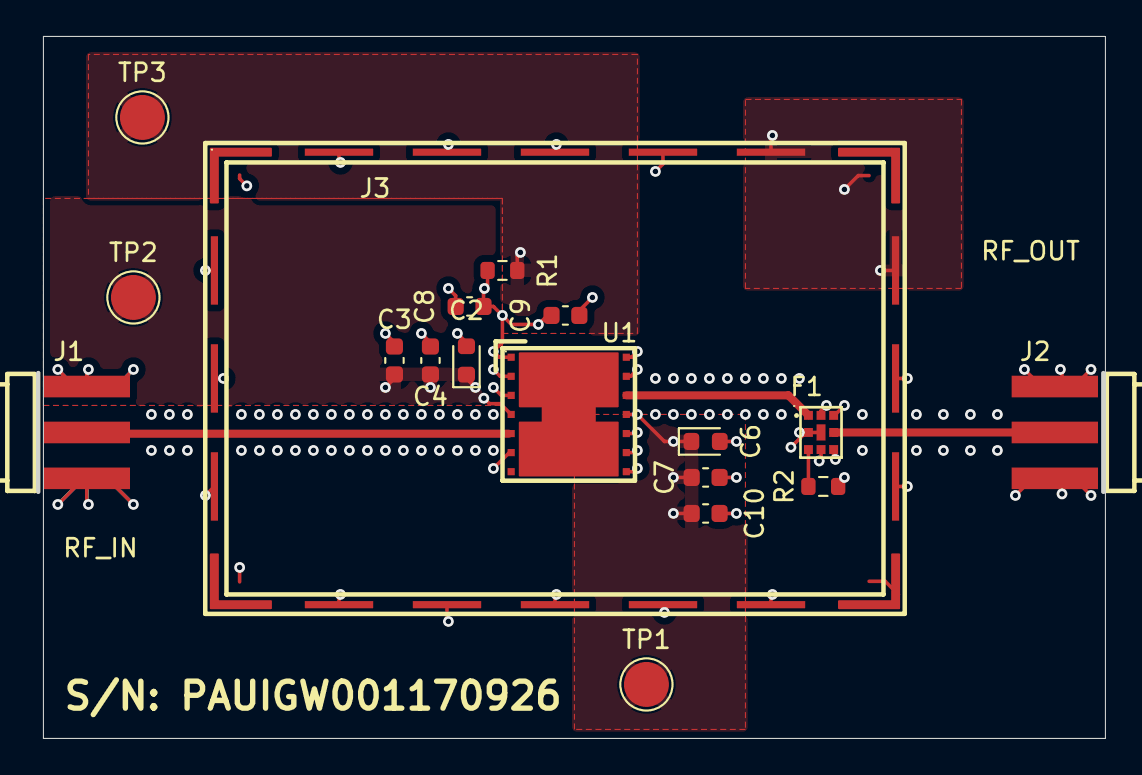
[picture p27: board _restore_backup_2026-10-14T10-31-09-348/pa_usrp_ui.kicad_pcb from above]

Board: 4 copper layers, 59.0 x 39.0 mm, 18 parts (0 on the bottom side), 9 nets.

Parts:
C2, C6: 10.0uF; D_0603_1608Metric
C3, C9, C10: 0.1uF; C_0603_1608Metric
C4, C7: 1000pF; C_0603_1608Metric
C8: 100pF; C_0603_1608Metric
F1: QPQ1297TR7; FILTER-SMD_9P-L2.5-W2.0-BL_QPQ1297TR7
J1, J2: BWSMA-KE-P001; SMA-SMD_BWSMA-KE-P001
J3: 2118722-2; CONN-SMD_2118722-2
R1: 0; R_0603_1608Metric
R2: 50; R_0603_1608Metric
TP1: VCC1; TestPoint_Pad_D2.5mm
TP2: VCC2; TestPoint_Pad_D2.5mm
TP3: VREF; TestPoint_Pad_D2.5mm
U1: QPA9418TR13; DFN-14_L7.0-W7.0-P1.06-TL-EP_QPA9418TR13

Connections:
GNDREF: C2.2, C3.2, C4.2, C6.2, C7.2, C8.2, C9.2, C10.2, F1.2 (GND), F1.4 (GND), F1.5 (GND), F1.7 (GND), F1.8 (GND), F1.9 (GND), J1.1, J1.2, J1.3, J1.4, J2.1, J2.2, J2.3, J2.4, J3.1, J3.2, J3.3, J3.4, J3.5, J3.6, J3.7, J3.8, J3.9, J3.10, J3.11, J3.12, J3.13, J3.14, J3.15, J3.16, J3.17, J3.18, J3.19, J3.20, R2.1, U1.2 (GND), U1.3 (GND), U1.6 (GND), U1.8 (GND), U1.9 (GND), U1.10 (GND), U1.13 (GND), U1.14 (GND)
unnamed: F1.6 (ANT), J2.5
unnamed: F1.1 (B3DL), U1.12 (RFOUT)
unnamed: F1.3 (B3UL), R2.2
unnamed: J1.5, U1.5 (RFIN)
unnamed: C8.1, C9.1, R1.2, U1.1 (VREF)
VCC1: C2.1, C3.1, C4.1, TP2.1 (1_1), U1.4 (VCC1)
VCC2: C6.1, C7.1, C10.1, TP1.1 (1_1), U1.11 (VCC2)
VREF: R1.1, TP3.1 (1_1)
